kevinkessler/NixieClock/pcbs/NixieController/NixieController.pdf

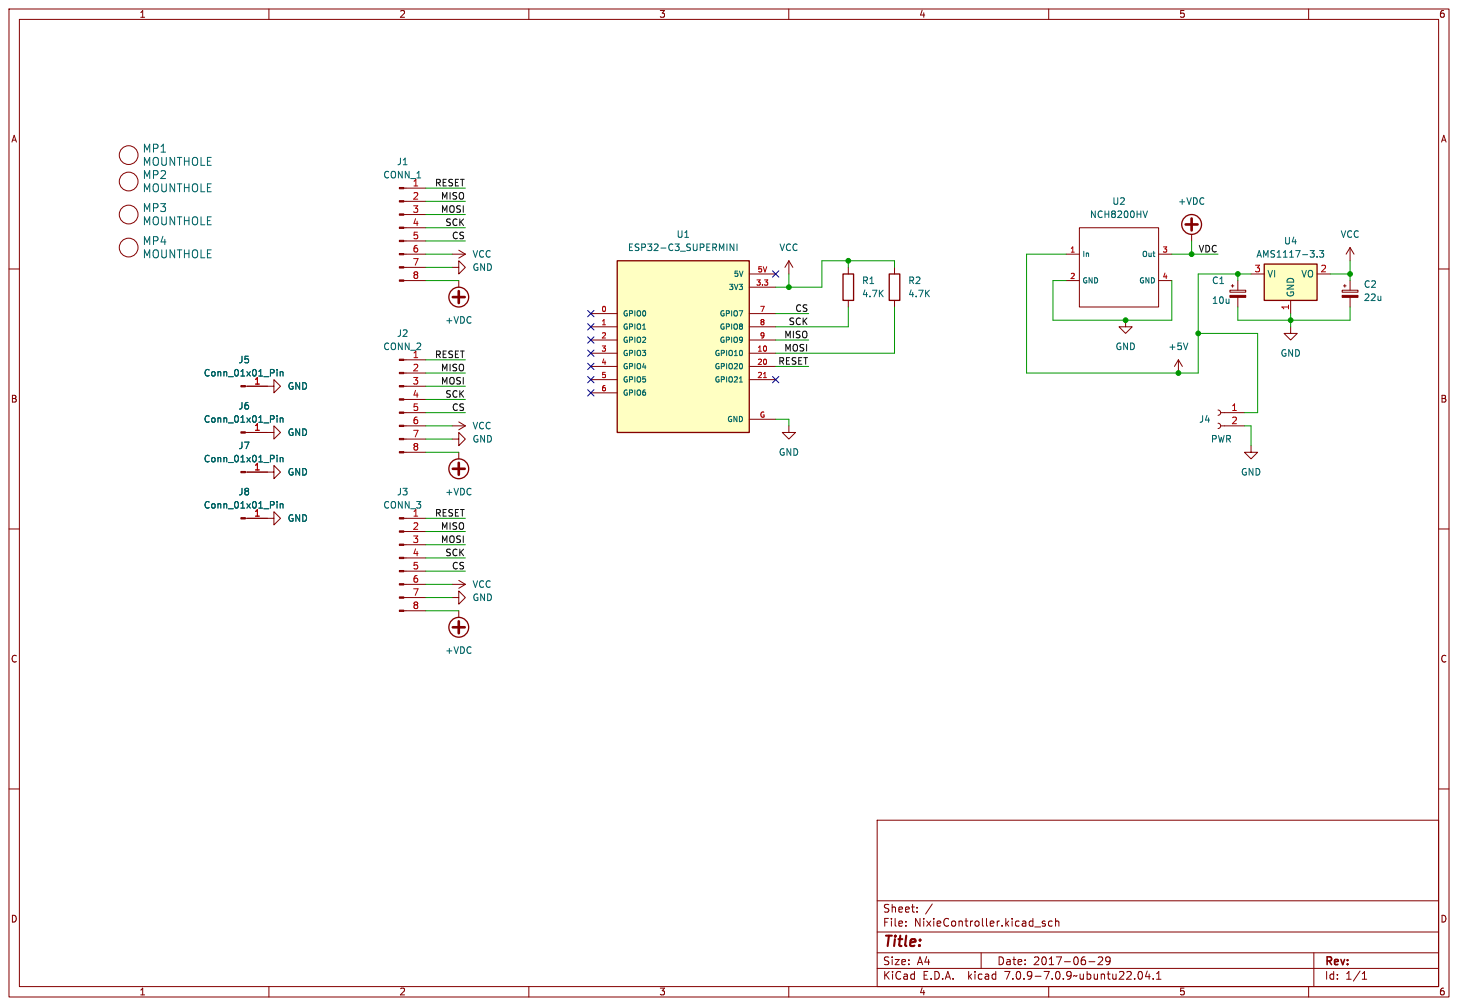
[picture p1: page 1]

Id: 1/1 Title: File: NixieController.kicad_sch Sheet: /
