kevinkessler/NixieClock/pcbs/NixieDualModule/NixieDualMod.pdf

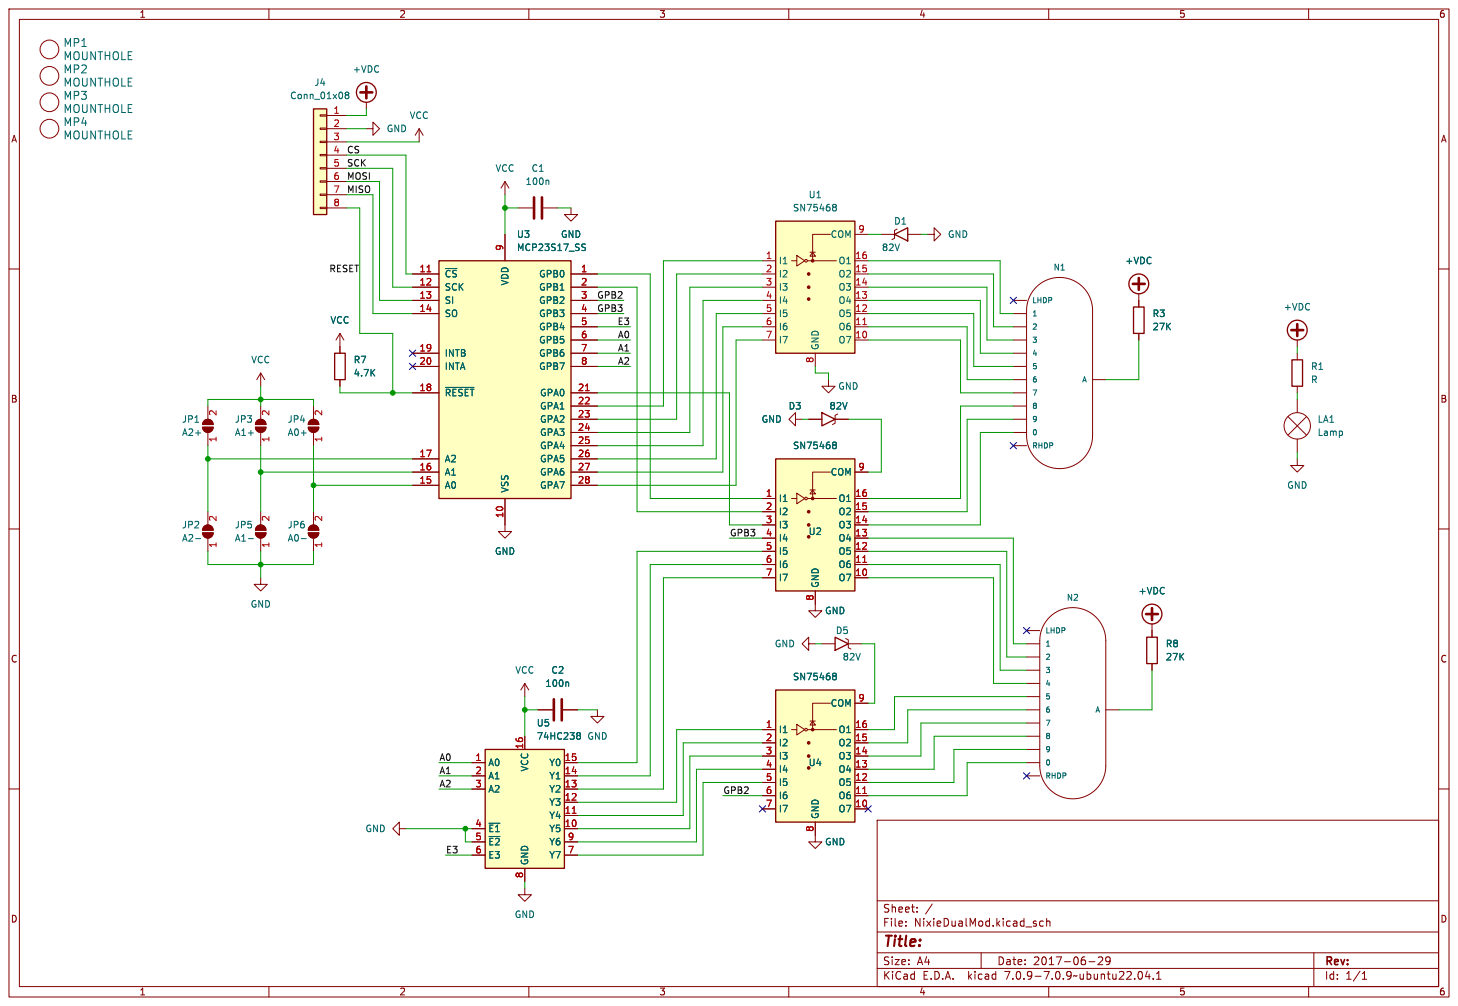
[picture p2: page 1]

Id: 1/1 Title: File: NixieDualMod.kicad_sch Sheet: /
