kevinkessler/NixieClock/pcbs/NixieController/pcb.pdf

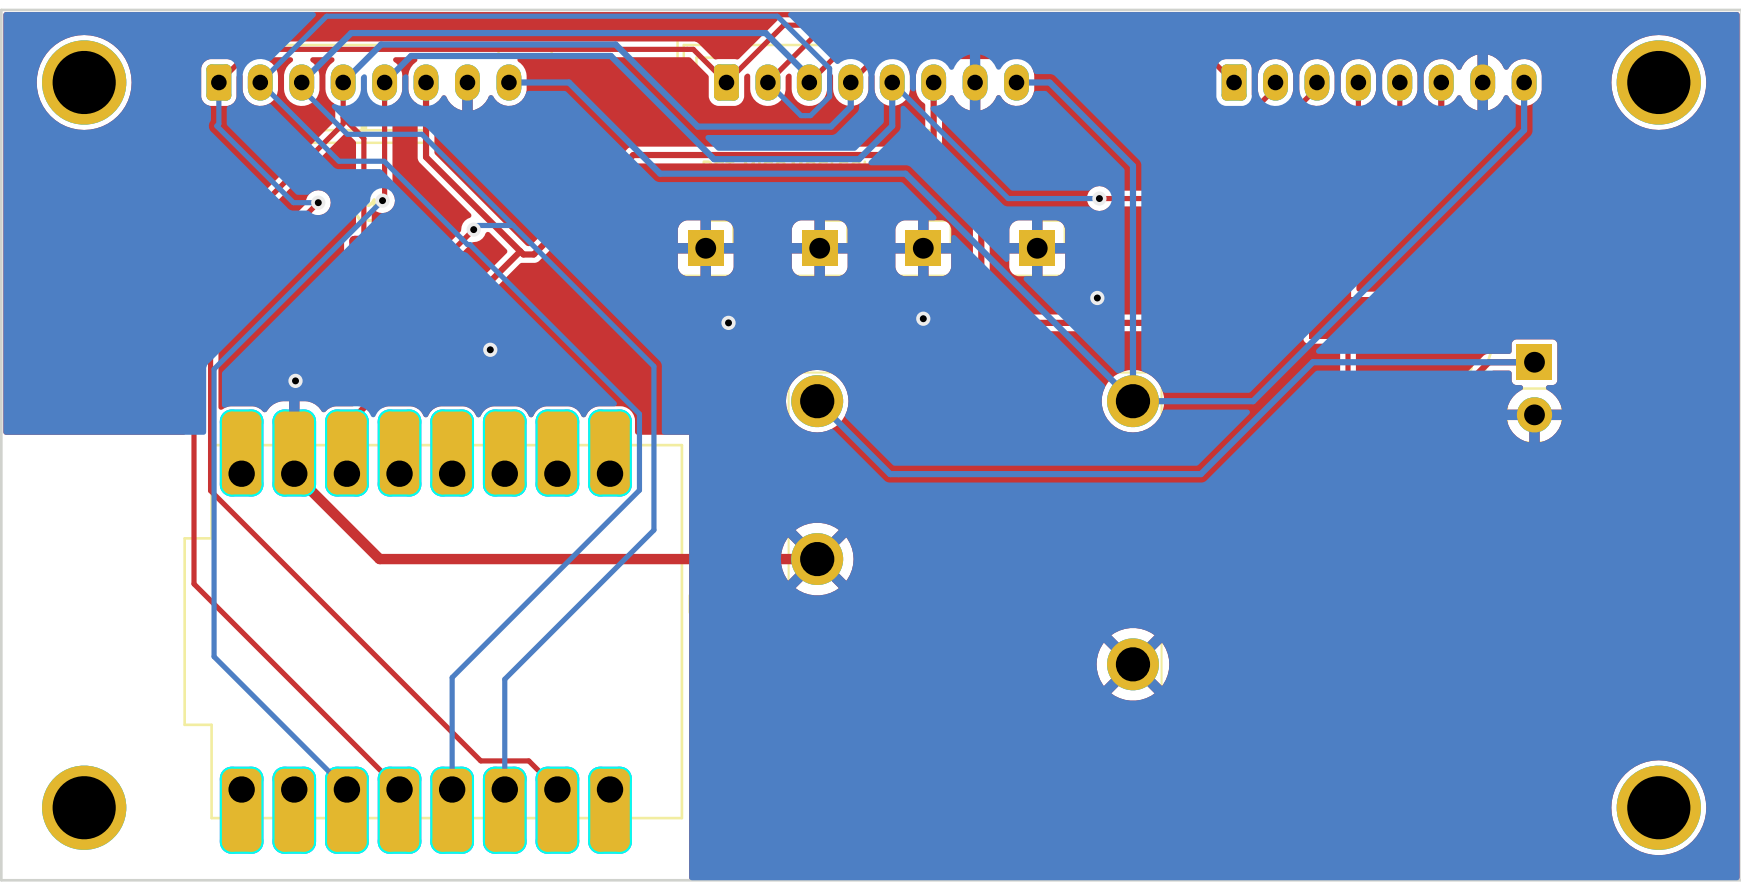
[picture p3: page 1]
