kevinkessler/NixieClock/pcbs/NixieDualModule/pcb.pdf

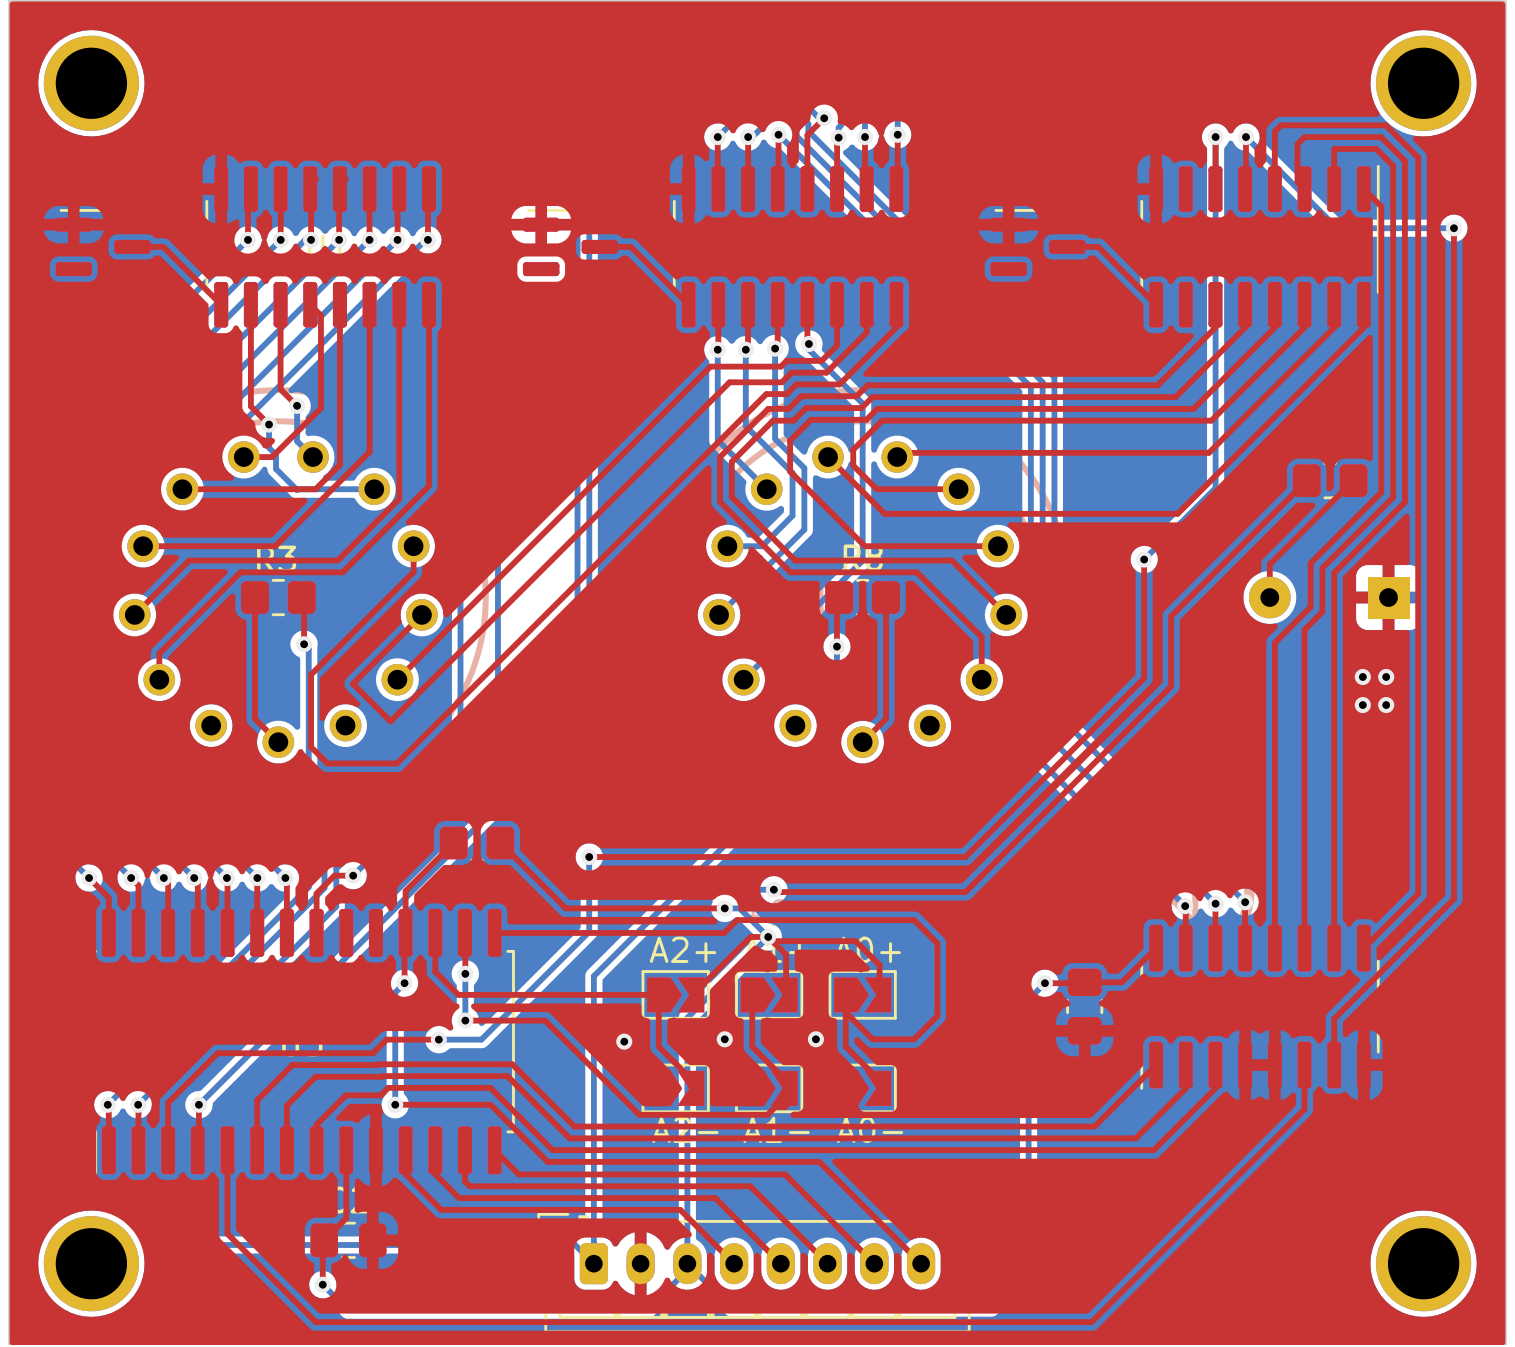
[picture p4: page 1]
