kevinkessler/NixieClock/pcbs/NixieController/NixieController.kicad_pcb

## KiCad design pcbs/NixieController/NixieController.kicad_pcb (2024-05-03)

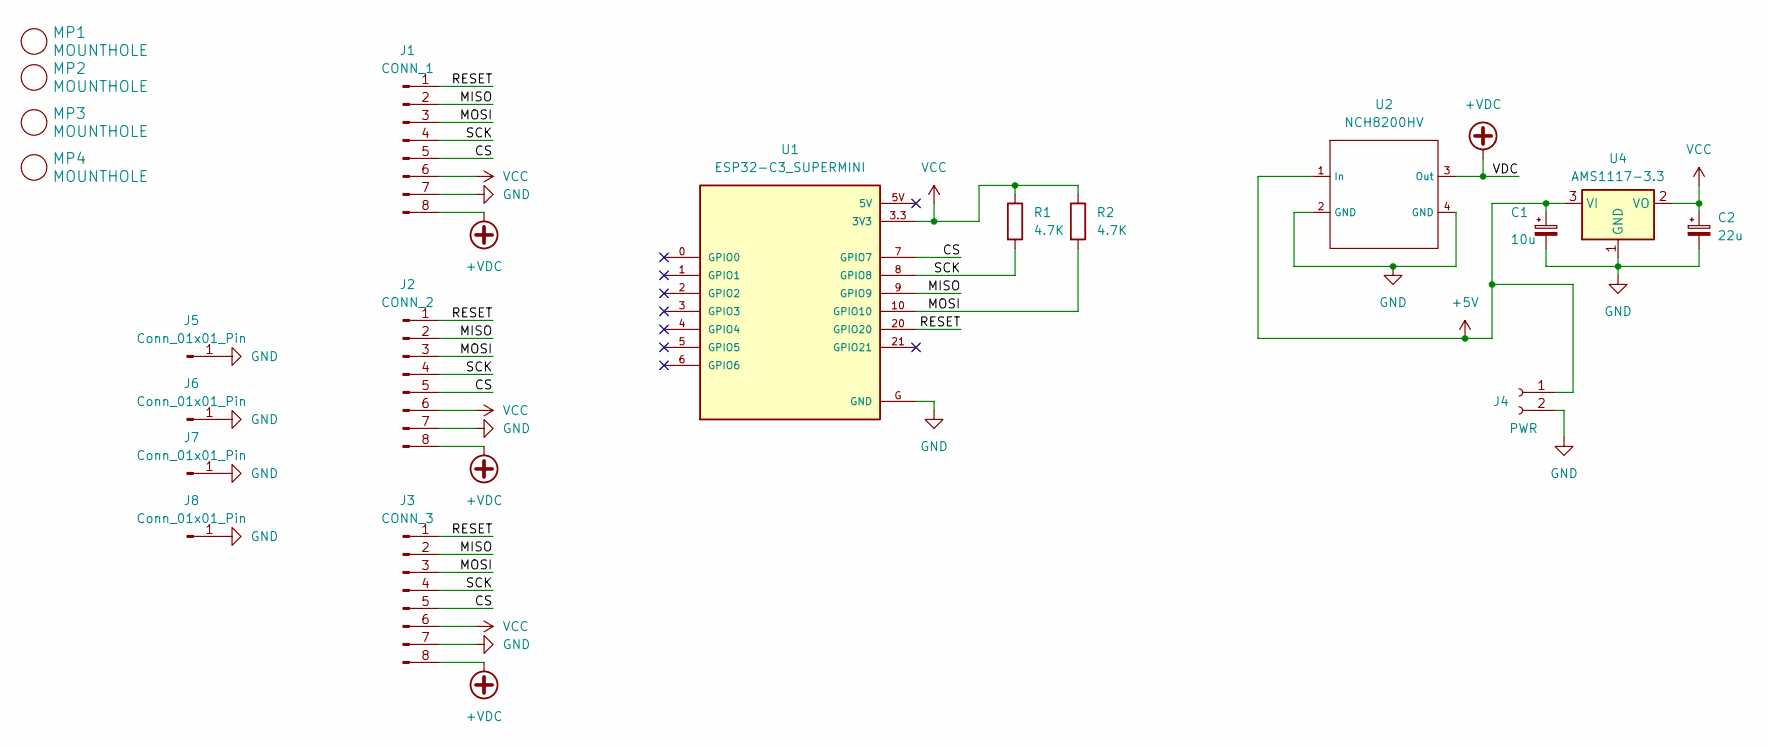
[picture p5: schematic NixieController.kicad_sch]

Parts:
C1: 10u; CP_Elec_5x5.3
C2: 22u; CP_Elec_6.3x7.7
J1: CONN_1; JST_PH_B8B-PH-K_1x08_P2.00mm_Vertical
J2: CONN_2; JST_PH_B8B-PH-K_1x08_P2.00mm_Vertical
J3: CONN_3; JST_PH_B8B-PH-K_1x08_P2.00mm_Vertical
J4: PWR; PinSocket_1x02_P2.54mm_Vertical
J5, J6, J7, J8: Conn_01x01_Pin; PinSocket_1x01_P2.54mm_Vertical
MP1, MP2, MP3, MP4: MOUNTHOLE; TH-M3
R1, R2: 4.7K; R_0805_2012Metric_Pad1.20x1.40mm_HandSolder
U1: ESP32-C3_SUPERMINI; MODULE_ESP32-C3_SUPERMINI
U2: NCH8200HV
U4: AMS1117-3.3; SOT-223-3_TabPin2

Connections:
+5V: C1.1, J4.1, U2.1 (In), U4.3 (VI)
+VDC: J1.8, J2.8, J3.8, U2.3 (Out)
/CS: J1.5, J2.5, J3.5, U1.7 (GPIO7)
/MISO: J1.2, J2.2, J3.2, U1.9 (GPIO9)
/MOSI: J1.3, J2.3, J3.3, R2.2, U1.10 (GPIO10)
/RESET: J1.1, J2.1, J3.1, U1.20 (GPIO20)
/SCK: J1.4, J2.4, J3.4, R1.2, U1.8 (GPIO8)
GND: C1.2, C2.2, J1.7, J2.7, J3.7, J4.2, J5.1, J6.1, J7.1, J8.1, U1.G (GND), U2.2 (GND), U2.4 (GND), U4.1 (GND)
VCC: C2.1, J1.6, J2.6, J3.6, R1.1, R2.1, U1.3.3 (3V3), U4.2 (VO)

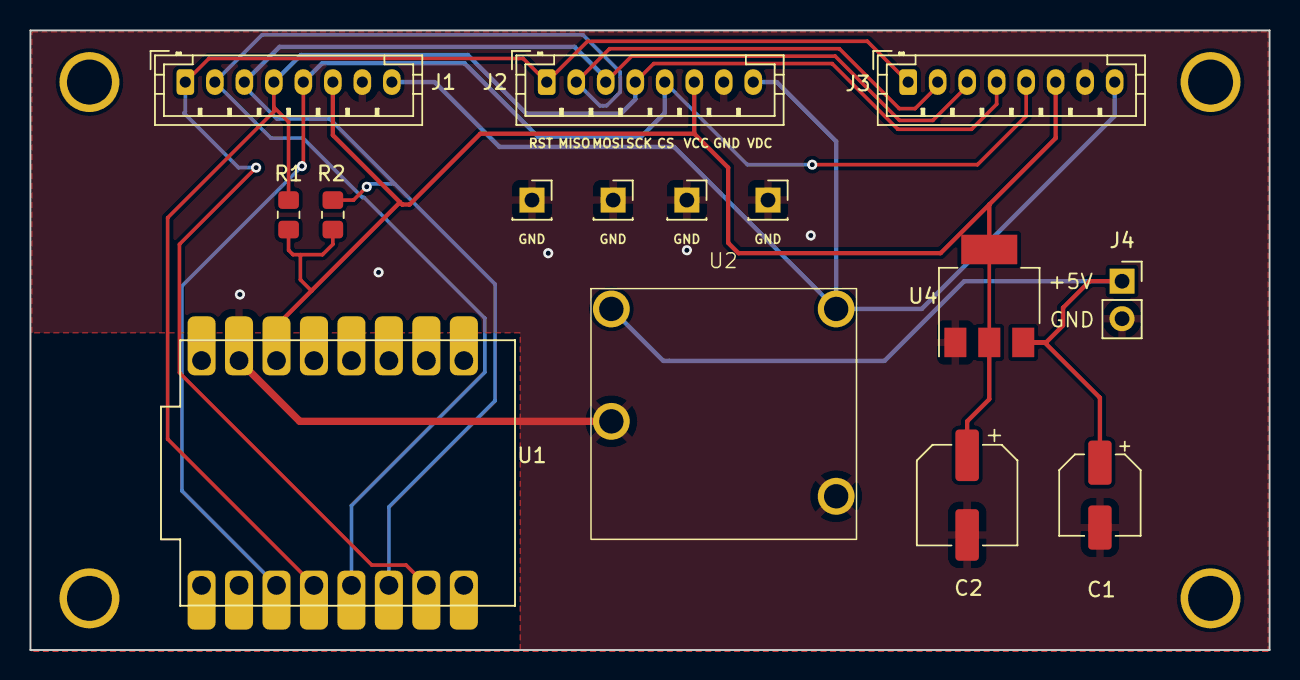
[picture p6: board NixieController.kicad_pcb from above]

Board: 2 copper layers, 84.0 x 42.0 mm, 19 parts (0 on the bottom side), 9 nets.
