kevinkessler/NixieClock/pcbs/NixieDualModule/NixieDualMod.kicad_pcb

## KiCad design pcbs/NixieDualModule/NixieDualMod.kicad_pcb (2024-05-03)

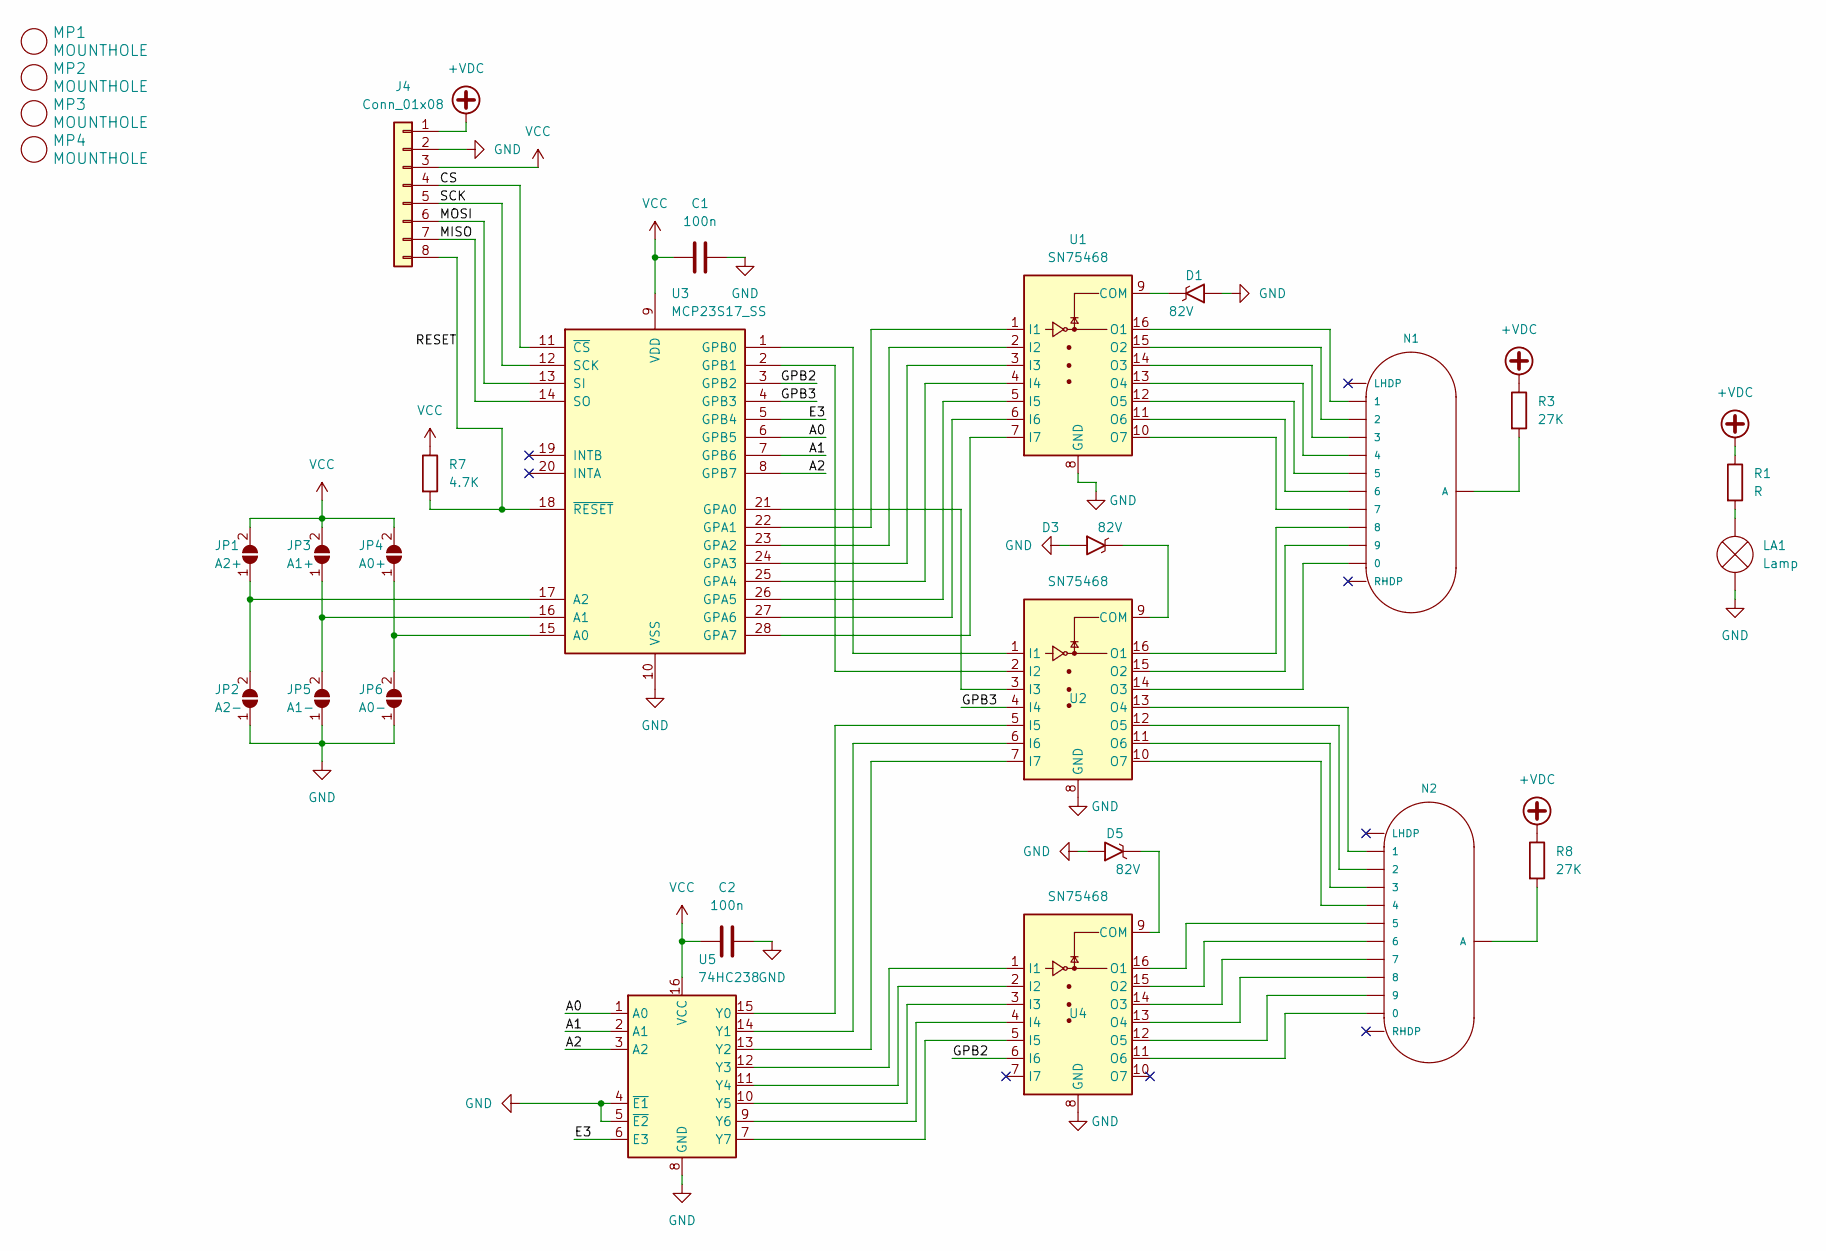
[picture p7: schematic NixieDualMod.kicad_sch]

Parts:
C1, C2: 100n; C_0805_2012Metric_Pad1.18x1.45mm_HandSolder
D1, D3, D5: 82V; Zener_SOT-23-3
J4: Conn_01x08; JST_PH_B8B-PH-K_1x08_P2.00mm_Vertical
JP1: A2+; SolderJumper-2_P1.3mm_Open_TrianglePad1.0x1.5mm
JP2: A2-; SolderJumper-2_P1.3mm_Open_TrianglePad1.0x1.5mm
JP3: A1+; SolderJumper-2_P1.3mm_Open_TrianglePad1.0x1.5mm
JP4: A0+; SolderJumper-2_P1.3mm_Open_TrianglePad1.0x1.5mm
JP5: A1-; SolderJumper-2_P1.3mm_Open_TrianglePad1.0x1.5mm
JP6: A0-; SolderJumper-2_P1.3mm_Open_TrianglePad1.0x1.5mm
LA1: Lamp; Valve_Glimm
MP1, MP2, MP3, MP4: MOUNTHOLE; TH-M3
N1, N2: IN-1; nixies-us-IN-14
R1: R; R_0805_2012Metric_Pad1.20x1.40mm_HandSolder
R3, R8: 27K; R_0805_2012Metric_Pad1.20x1.40mm_HandSolder
R7: 4.7K; R_0805_2012Metric_Pad1.20x1.40mm_HandSolder
U1, U2, U4: SN75468; SOIC-16_3.9x9.9mm_P1.27mm
U3: MCP23S17_SS; SOIC-28W_7.5x17.9mm_P1.27mm
U5: 74HC238; SOP-16_3.9x9.9mm_P1.27mm

Connections:
+VDC: J4.1, R1.1, R3.1, R8.1
/A0: U3.6 (GPB5), U5.1 (A0)
/A1: U3.7 (GPB6), U5.2 (A1)
/A2: U3.8 (GPB7), U5.3 (A2)
/CS: J4.4, U3.11 (~CS)
/E3: U3.5 (GPB4), U5.6 (E3)
/GPB2: U3.3 (GPB2), U4.6 (I6)
/GPB3: U2.4 (I4), U3.4 (GPB3)
/MISO: J4.7, U3.14 (SO)
/MOSI: J4.6, U3.13 (SI)
/RESET: J4.8, R7.2, U3.18 (~RESET)
/SCK: J4.5, U3.12 (SCK)
GND: C1.2, C2.2, D1.1 (A), D3.1 (A), D5.1 (A), J4.2, JP2.1 (A), JP5.1 (A), JP6.1 (A), LA1.1 (-), U1.8 (GND), U2.8 (GND), U3.10 (VSS), U4.8 (GND), U5.4 (~E1), U5.5 (~E2), U5.8 (GND)
unnamed: D1.3 (K), U1.9 (COM)
unnamed: D3.3 (K), U2.9 (COM)
unnamed: D5.3 (K), U4.9 (COM)
unnamed: JP1.1 (A), JP2.2 (B), U3.17 (A2)
unnamed: JP3.1 (A), JP5.2 (B), U3.16 (A1)
unnamed: JP4.1 (A), JP6.2 (B), U3.15 (A0)
unnamed: LA1.2 (+), R1.2
unnamed: N1.A, R3.2
unnamed: N2.A, R8.2
unnamed: U1.1 (I1), U3.22 (GPA1)
unnamed: U1.2 (I2), U3.23 (GPA2)
unnamed: U1.3 (I3), U3.24 (GPA3)
unnamed: U1.4 (I4), U3.25 (GPA4)
unnamed: U1.5 (I5), U3.26 (GPA5)
unnamed: U1.6 (I6), U3.27 (GPA6)
unnamed: U1.7 (I7), U3.28 (GPA7)
unnamed: N1.1, U1.16 (O1)
unnamed: N1.2, U1.15 (O2)
unnamed: N1.3, U1.14 (O3)
unnamed: N1.4, U1.13 (O4)
unnamed: N1.5, U1.12 (O5)
unnamed: N1.6, U1.11 (O6)
unnamed: N1.7, U1.10 (O7)
unnamed: U2.1 (I1), U3.1 (GPB0)
unnamed: U2.2 (I2), U3.2 (GPB1)
unnamed: U2.3 (I3), U3.21 (GPA0)
unnamed: U2.5 (I5), U5.15 (Y0)
unnamed: U2.6 (I6), U5.14 (Y1)
unnamed: U2.7 (I7), U5.13 (Y2)
unnamed: N1.8, U2.16 (O1)
unnamed: N1.9, U2.15 (O2)
unnamed: N1.0, U2.14 (O3)
unnamed: N2.1, U2.13 (O4)
unnamed: N2.2, U2.12 (O5)
unnamed: N2.3, U2.11 (O6)
unnamed: N2.4, U2.10 (O7)
unnamed: U4.1 (I1), U5.12 (Y3)
unnamed: U4.2 (I2), U5.11 (Y4)
unnamed: U4.3 (I3), U5.10 (Y5)
unnamed: U4.4 (I4), U5.9 (Y6)
unnamed: U4.5 (I5), U5.7 (Y7)
unnamed: N2.5, U4.16 (O1)
unnamed: N2.6, U4.15 (O2)
unnamed: N2.7, U4.14 (O3)
unnamed: N2.8, U4.13 (O4)
unnamed: N2.9, U4.12 (O5)
unnamed: N2.0, U4.11 (O6)
VCC: C1.1, C2.1, J4.3, JP1.2 (B), JP3.2 (B), JP4.2 (B), R7.1, U3.9 (VDD), U5.16 (VCC)

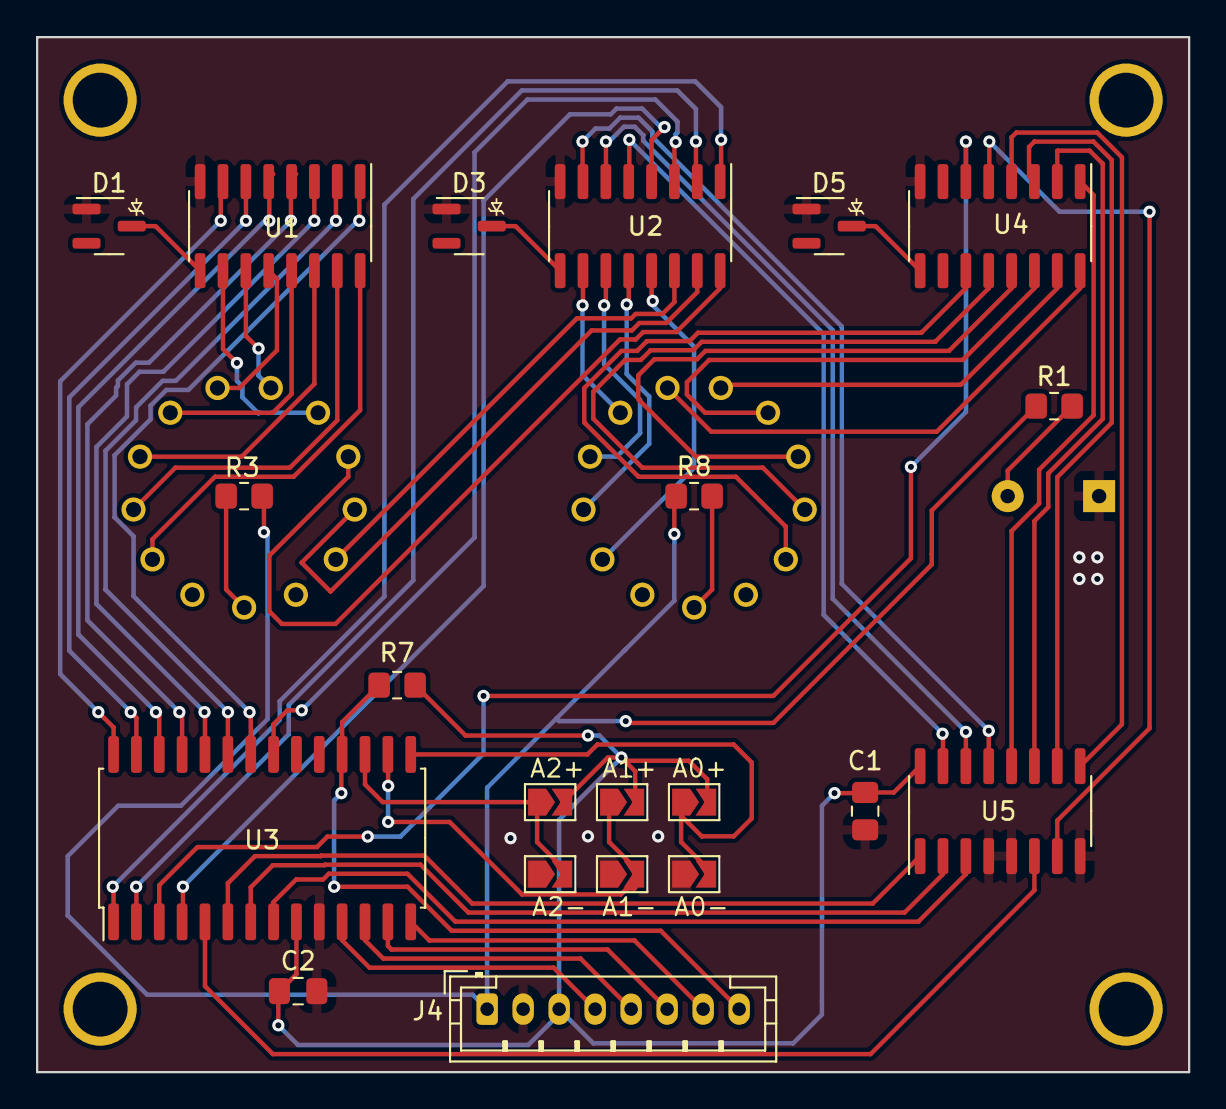
[picture p8: board NixieDualMod.kicad_pcb from above]

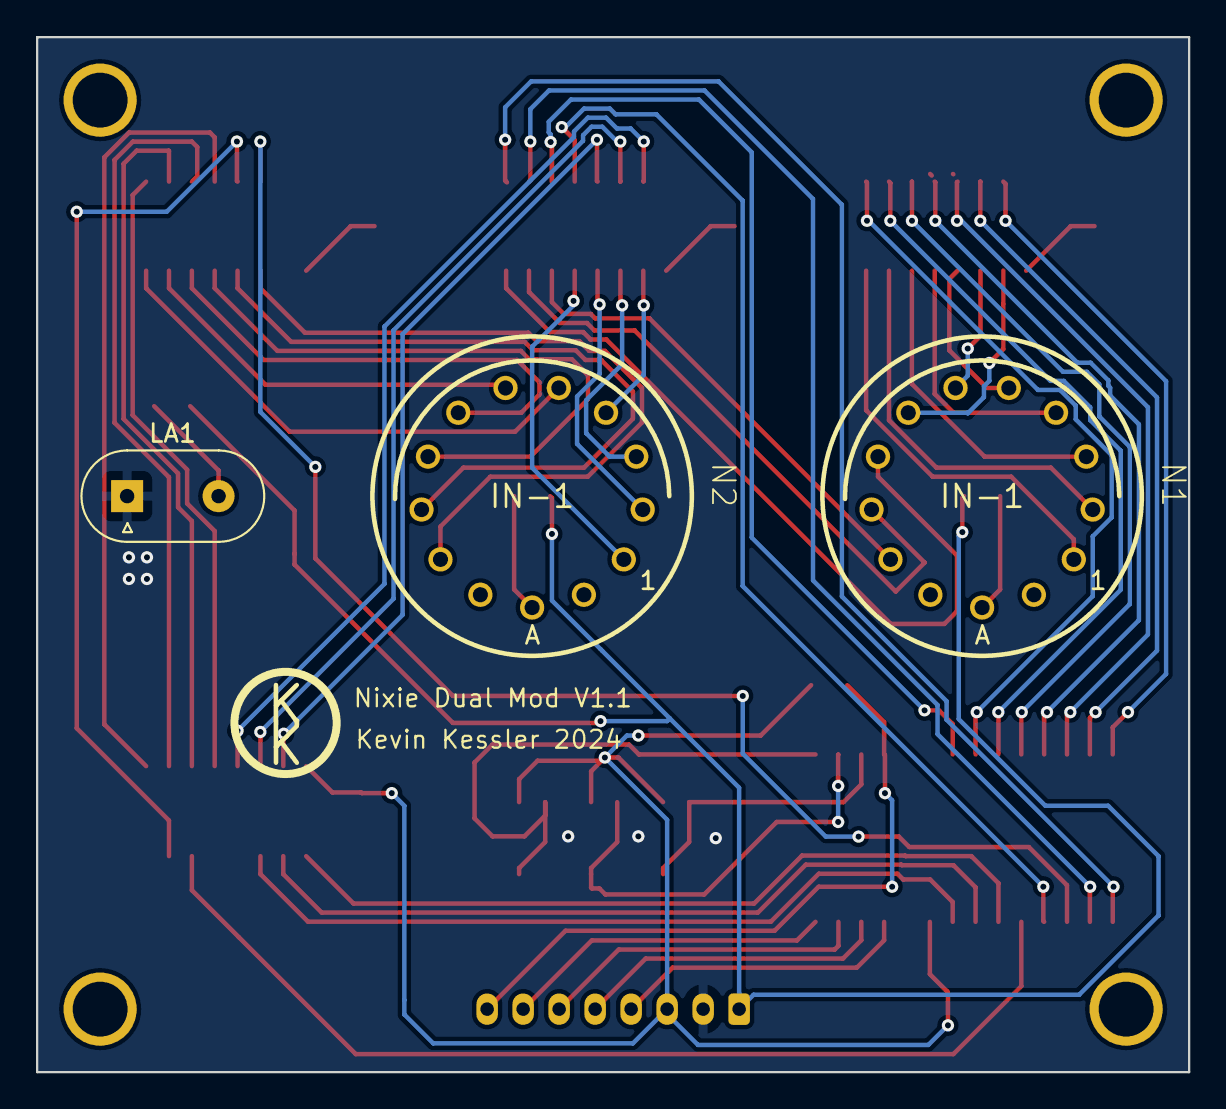
[picture p9: board NixieDualMod.kicad_pcb from below]

Board: 2 copper layers, 64.0 x 57.5 mm, 28 parts (3 on the bottom side), 61 nets.
